GlorijaDoslo/Arduino-DC-voltmeter/README.md

# Arduino-DC-voltmeter
Arduino DC voltmeter is a project where we made a DC voltmeter using an arduino microcontroller and an electric circuit.

## Authors
Developed by the following team from [University of Belgrade – School of Electrical Engineering](https://www.etf.bg.ac.rs): 
* Kristina Rajković
* Glorija Došlo.

## Ackowlegment
We thank Prof. dr Nikola Basta for recommending this project to us and for all discussions and help with the project.
