GlorijaDoslo/Arduino-DC-voltmeter/Dokumentacija/Digitalni jednosmerni voltmetar.pptx

## Digitalni jednosmerni voltmetar

MENTOR:
DOC. DR NIKOLA BASTA

Studenti:
Glorija Došlo 2019/0065
Kristina Rajković 2019/0447

Teorija električnih kola, Elektrotehnički fakultet u beogradu, Februar 2022. g.

## Zadatak

Pomoću platforme Arduino ATMega 2560 napraviti digitalni DC (JEDNOSMERNI) VOLTMETAR i omogućiti očitavanje bipolarnog (pozitivnog i negativnog) napona na posmatranom elementu pomoću računara, numerički i grafički. Test naponi treba da budu u opsegu ±9 V. Obezbediti mapiranje bipolarnog napona na pozitivan ulazni napon analognog pina u opsegu od 0 do +5 V. Proveriti ispravnost i funkcionalnost voltmetra na prostom kolu napajanog baterijom od 9V.

## Sabirač

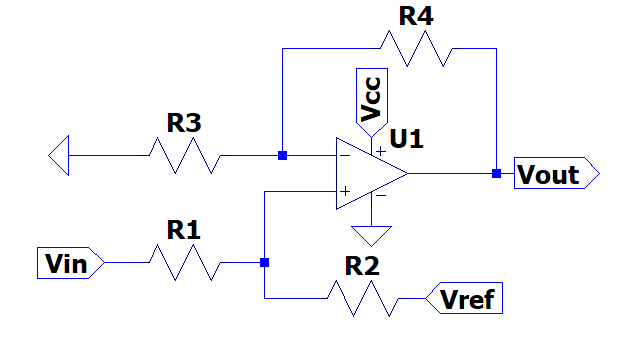
[picture p1: figure]

Ulazni napon

Napajanje operacionog pojačavača

Izlazni napon

Referentni napon

## Proračun

Ulazni napon

V_(out) =V_(in) g+V_(off)
g=(V_(cc) ^Γ)/(∆V_(in)) V_(off) =(−V_(inmin) V_(cc) ^Γ)/(∆V_(in))
V_(out) =(V_(in) (R_2)/(R_1 +R_2)+V_(ref) (R_1)/(R_1 +R_2))(1+(R_4)/(R_3))
x=(R_1)/(R_2) y=(R_4)/(R_3)
V_(ref) =−(V_(inmin))/x
y=(V_(cc) ^Γ (1+x))/(∆V_(in))−1
x>(∆V_(in))/(V_(cc) ^Γ)−1

Poznate veličine: minimalni i maksimalni ulazni i izlazni napon, odnos otpornosti x
Nepoznate veličine: odnos otpornosti y i referentni napon

Pojačanje operacionog pojačavača

Izlazni napon

Ofsetni napon

Transfer funkcija operacionog pojačavača

## Šema električnog kola

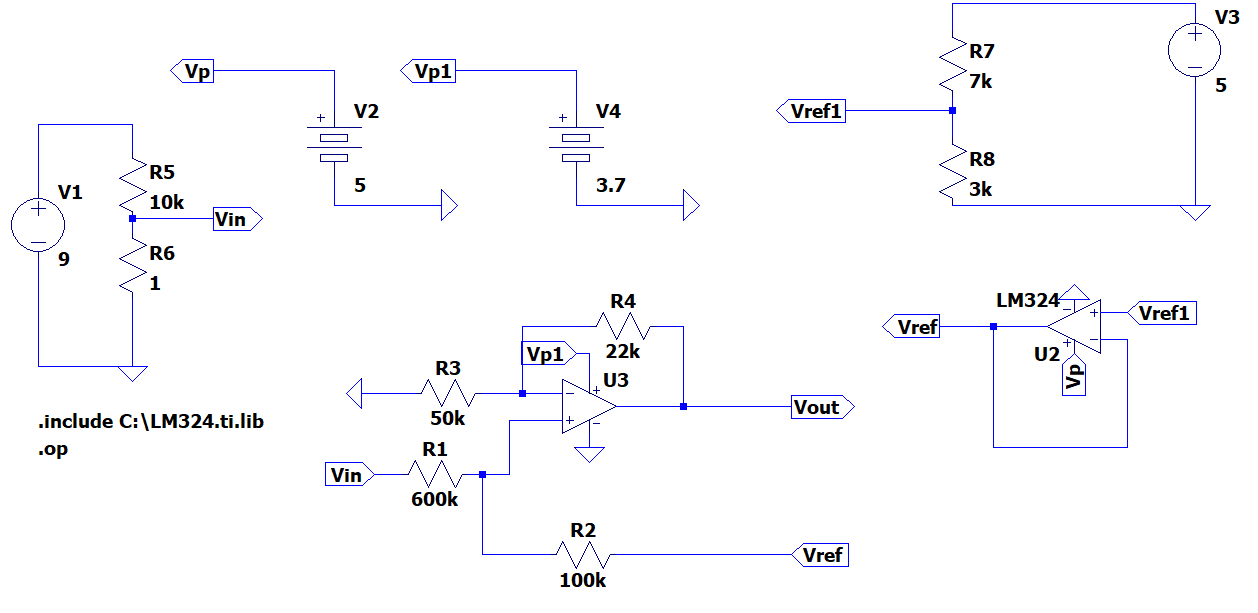
[picture p2: figure]

Napajanja

Mereni signal

Razdelnik napona

Test kolo

Jedinični operacioni pojačavač

Izlazni signal ka Arduino mikrokontroleru

Referentni napon

## Šema električnog kola u alatu Fritzing

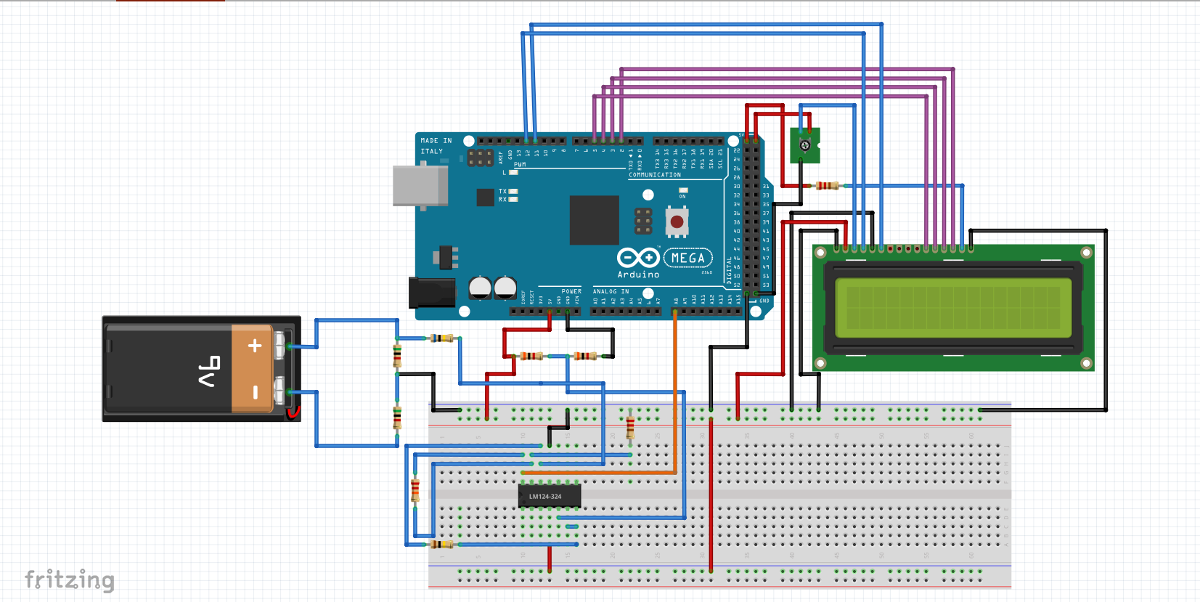
[picture p3: figure]

## Šema električnog kola u alatu Fritzing(1)

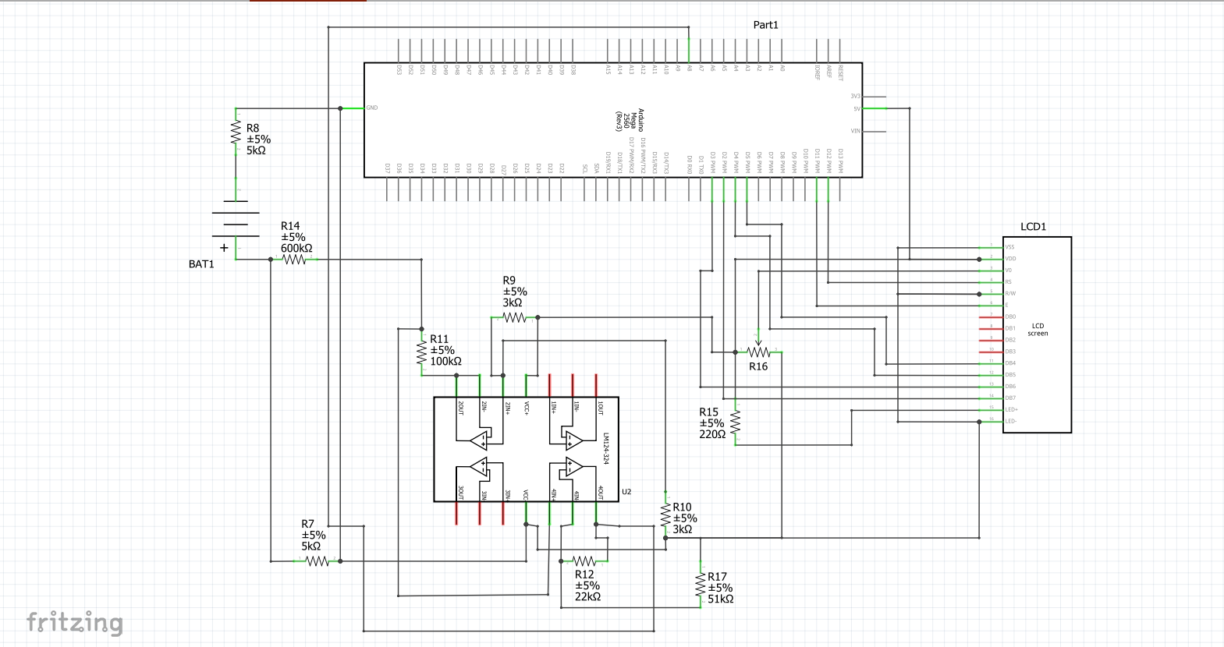
[picture p4: figure]

## Programiranje Arduino mikrokontrolera

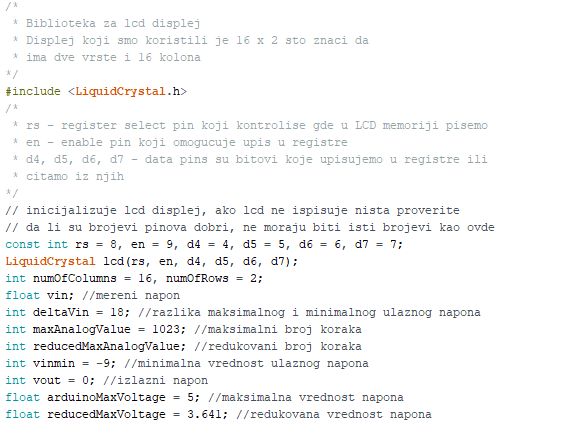
[picture p5: figure]

## Programiranje Arduino mikrokontrolera(1)

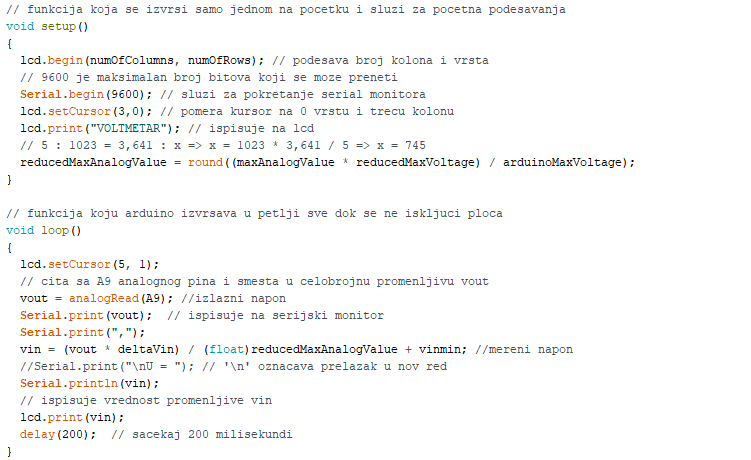
[picture p6: figure]

## Analiza greške

Analiza greške vršena je poređenjem tačnih vrednosti i vrednosti koje meri Arduino mikrokontroler što je prikazano na prvoj tabeli. Takođe, vršeno je poređenje merenih vrednosti multimetrom i Arduino mikrokontrolerom.

## Grafički korisnički interfejs

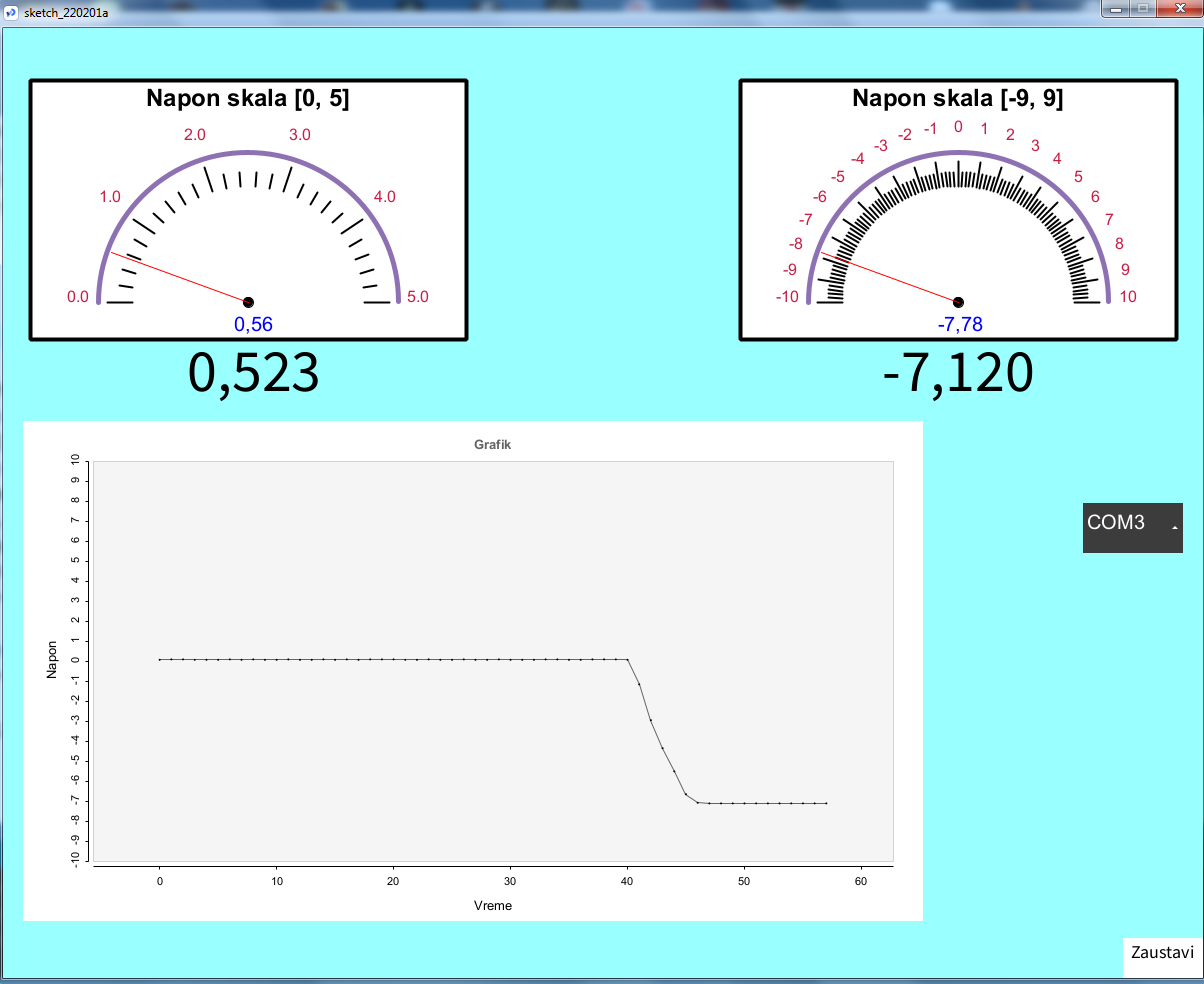
[picture p7: figure]

GUI aplikacija prikazuje napon kakav očitava Arduino mikrokontroler, mapiran u odgovarajući opseg, kao i mereni signal. Crta se i grafik zavisnosti merenog signala od vremena.
Moguće je izabrati port i vrši se provera da li na njemu postoji povezan Arduino mikrokontroler. Dugme „Zaustavi“ služi za zaustavljanje aplikacije, a ponovni pritisak na njega je ponovo pokreće. Aplikacija je zaštićena od grešaka u konekciji. Kompletan kod priložen je u dokumentaciji projekta.

## Slide 12

Hvala na pažnji!
