GlorijaDoslo/Arduino-DC-voltmeter/guiTEKmetar/data/meter1.PNG

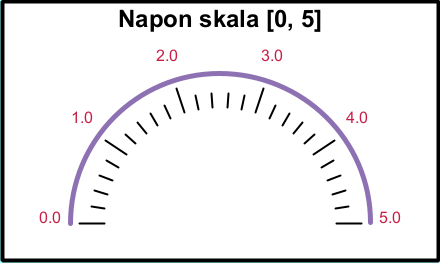
guiTEKmetar/data/meter1.PNG
