GlorijaDoslo/Arduino-DC-voltmeter/guiTEKmetar/data/meter2.PNG

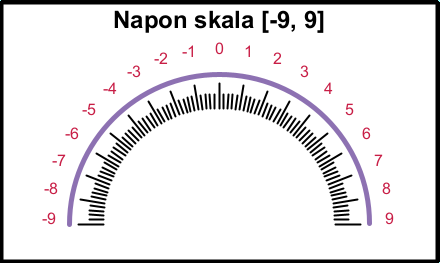
guiTEKmetar/data/meter2.PNG
